LorenzSteinke/Lichtsignal_H0/README.md

# Lichtsignal_H0
Light Signal for model railway in gauge H0/00
