LorenzSteinke/Lichtsignal_H0/Rueckwand-Blende.stl

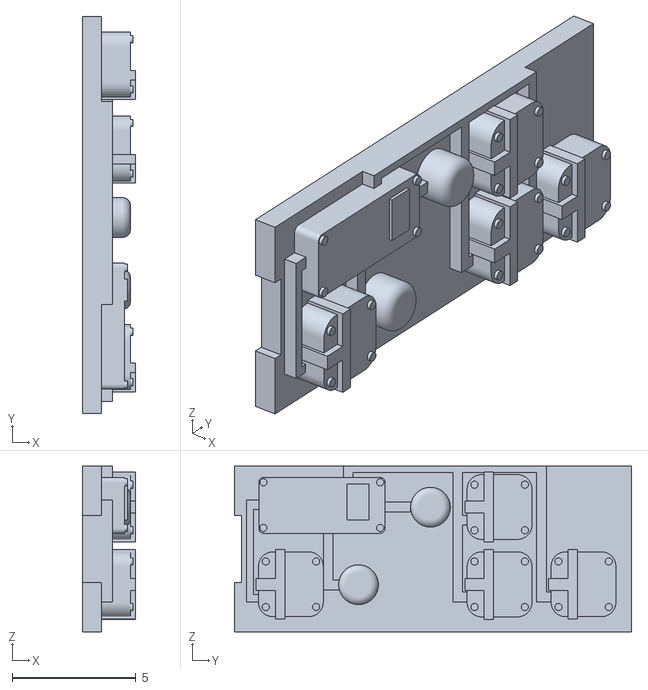
[picture p1: CAD file, 2020-01-09]
Rueckwand-Blende.stl
2.15 x 16.1 x 6.69
