LorenzSteinke/Lichtsignal_H0/Mastkorb.stl

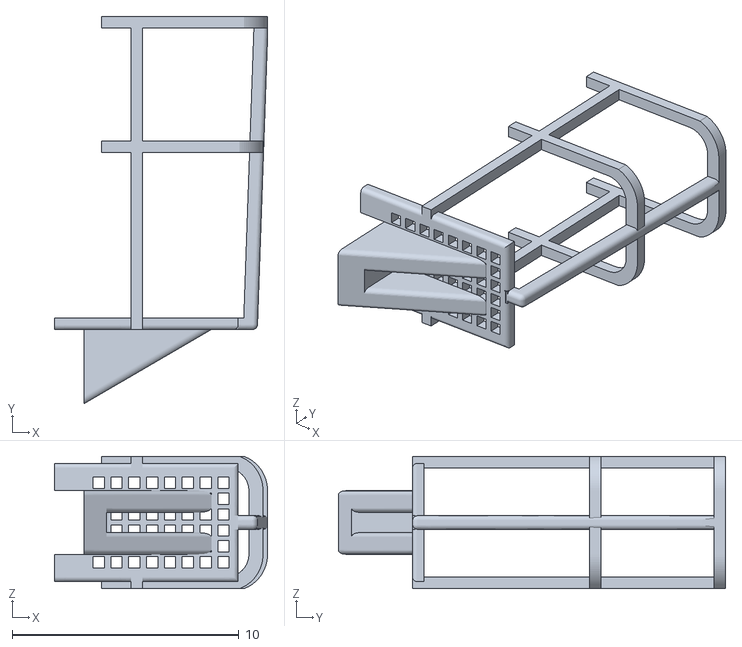
[picture p2: CAD file, 2020-01-09]
Mastkorb.stl
9.39 x 17.1 x 5.84
