LorenzSteinke/Lichtsignal_H0/Blende-Typ2.stl

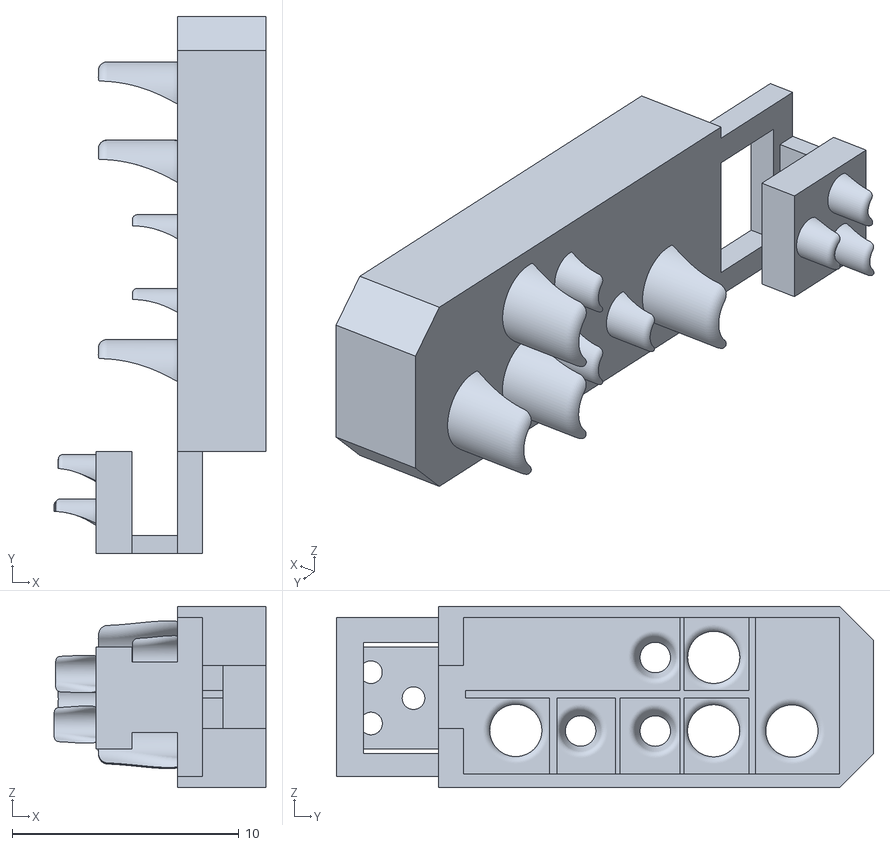
[picture p3: CAD file, 2020-01-09]
Blende-Typ2.stl
9.34 x 23.7 x 8.00
