LorenzSteinke/Lichtsignal_H0/Blende-Typ5.stl

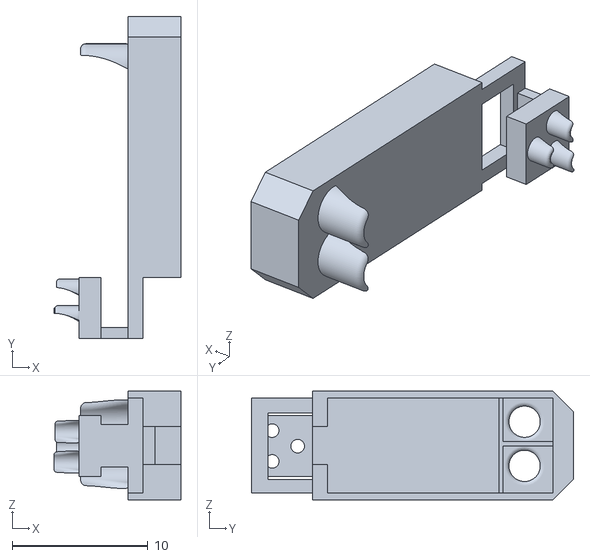
[picture p4: CAD file, 2020-01-09]
Blende-Typ5.stl
9.34 x 23.7 x 8.00
