LorenzSteinke/Lichtsignal_H0/Blende-Vorsignal.stl

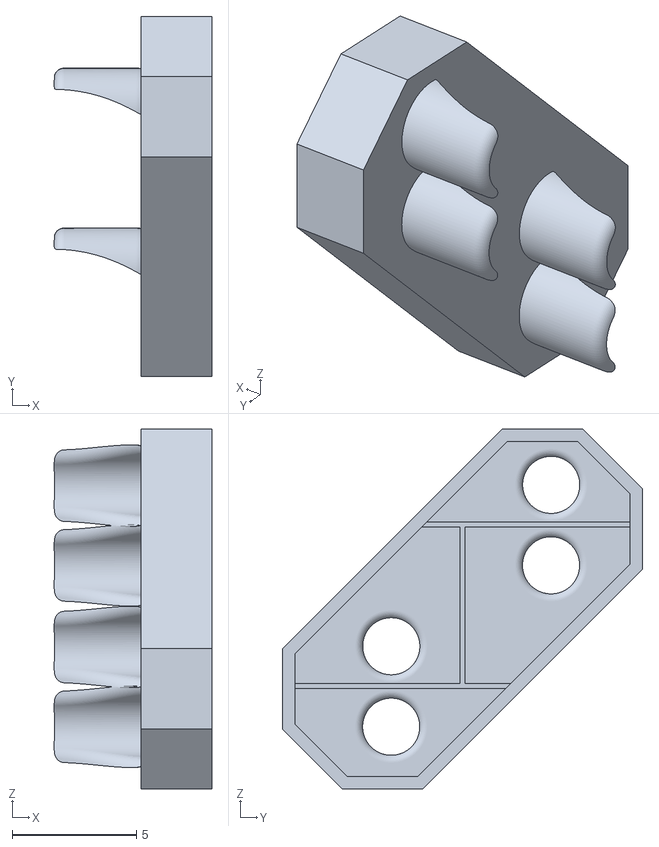
[picture p6: CAD file, 2020-01-09]
Blende-Vorsignal.stl
6.35 x 14.5 x 14.5
