LorenzSteinke/Lichtsignal_H0/Mast-mit-Vorsignal.stl

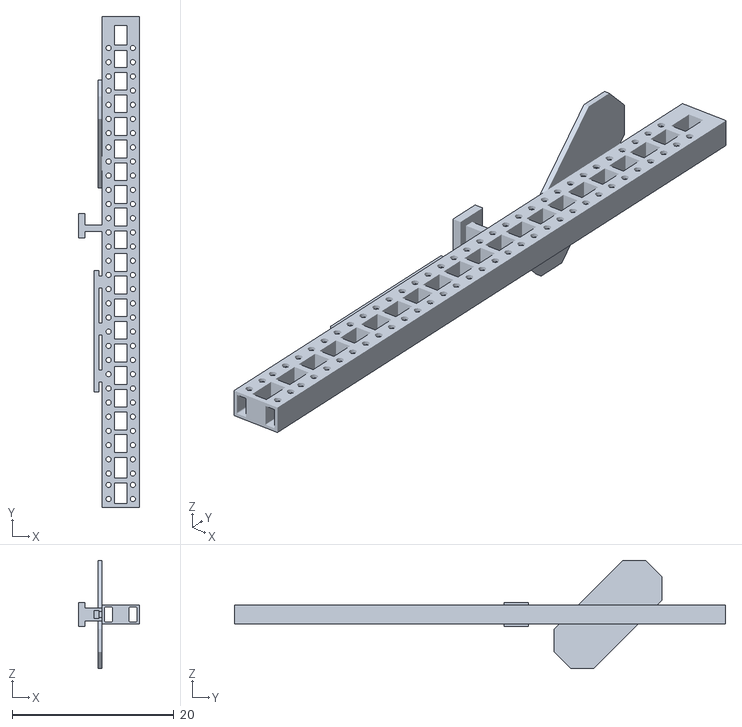
[picture p7: CAD file, 2020-01-09]
Mast-mit-Vorsignal.stl
7.50 x 60.7 x 13.4
