LorenzSteinke/Lichtsignal_H0/Blende-Vorsignal-mit-Verkuerzer.stl

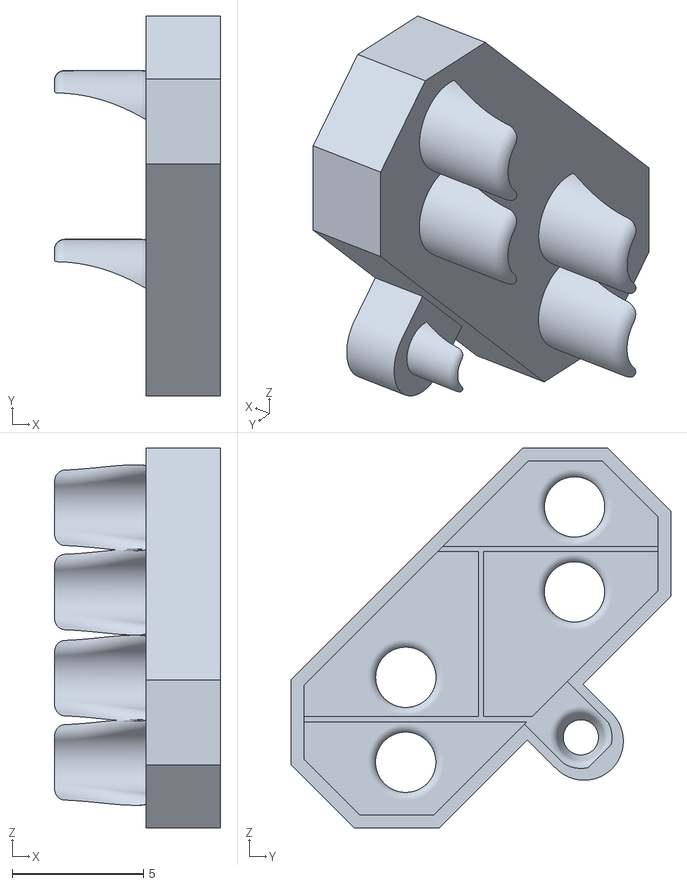
[picture p8: CAD file, 2020-01-09]
Blende-Vorsignal-mit-Verkuerzer.stl
6.35 x 14.5 x 14.5
