LorenzSteinke/Lichtsignal_H0/Verteilerkasten.stl

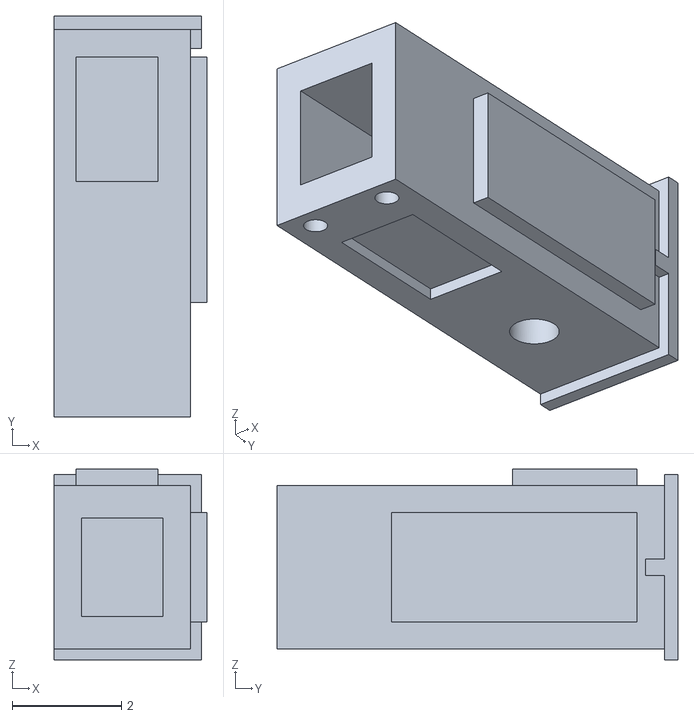
[picture p9: CAD file, 2020-01-09]
Verteilerkasten.stl
2.80 x 7.35 x 3.50
