LorenzSteinke/Lichtsignal_H0/Mastkorb-seitlich.stl

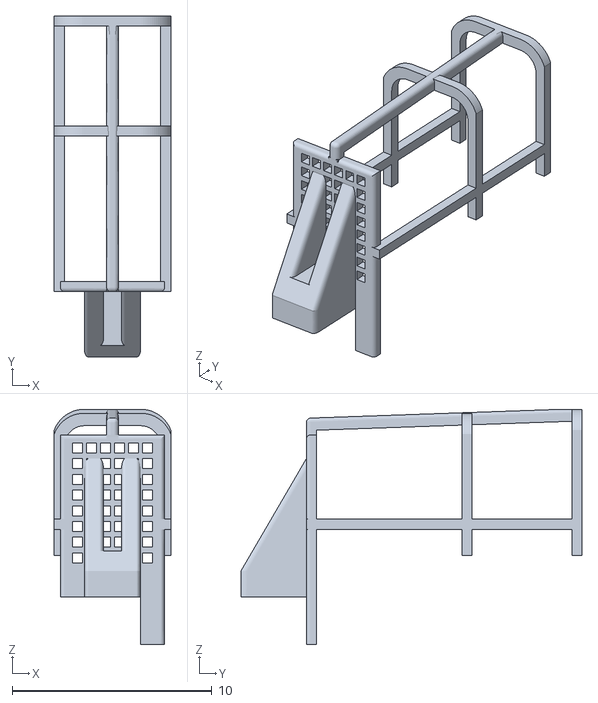
[picture p10: CAD file, 2020-01-09]
Mastkorb-seitlich.stl
5.84 x 17.1 x 11.8
