LorenzSteinke/Lichtsignal_H0/Blende-Typ1.stl

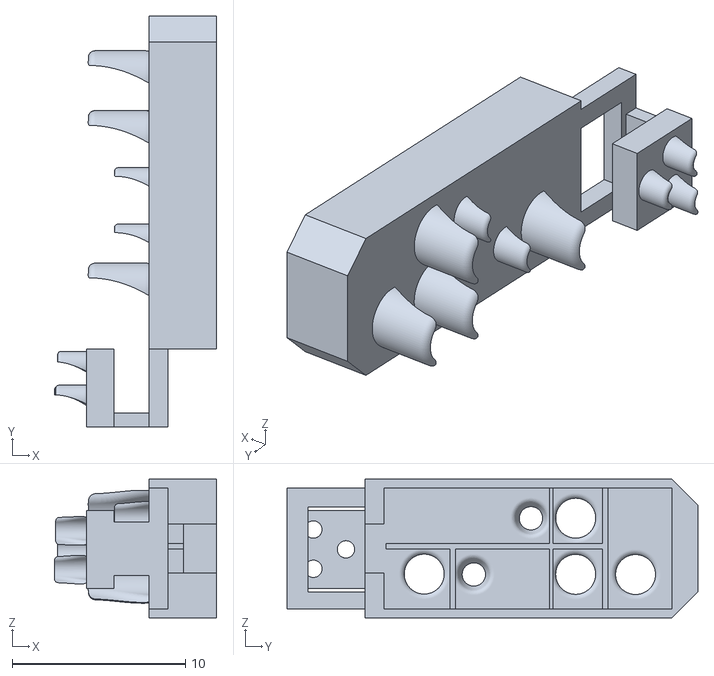
[picture p11: CAD file, 2020-01-09]
Blende-Typ1.stl
9.34 x 23.7 x 8.00
