LorenzSteinke/Lichtsignal_H0/Sockel-Platte-18mm.stl

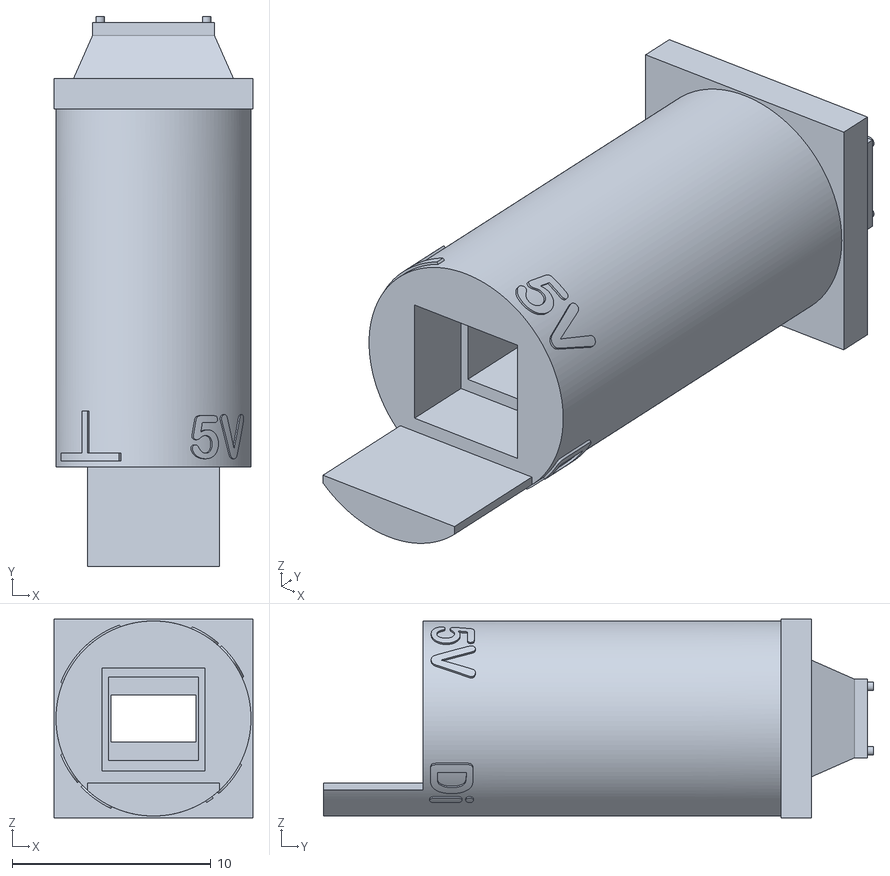
[picture p12: CAD file, 2019-12-20]
Sockel-Platte-18mm.stl
10.0 x 27.6 x 10.0
