LorenzSteinke/Lichtsignal_H0/Rueckwand.stl

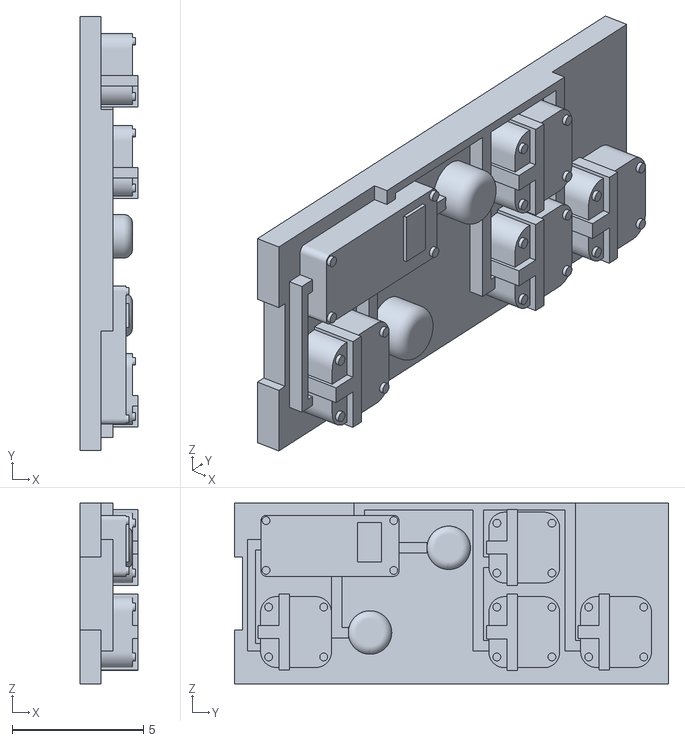
[picture p13: CAD file, 2019-12-06]
Rueckwand.stl
2.22 x 16.6 x 6.90
