LorenzSteinke/Lichtsignal_H0/Halterung-Wannenstecker-6pol.stl

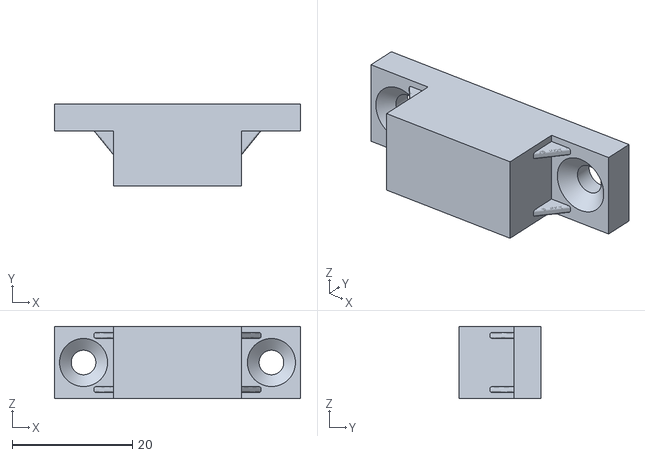
[picture p14: CAD file, 2019-11-26]
Halterung-Wannenstecker-6pol.stl
41.0 x 13.7 x 12.0
