LorenzSteinke/Lichtsignal_H0/Halterung-Wannenstecker-4pol.stl

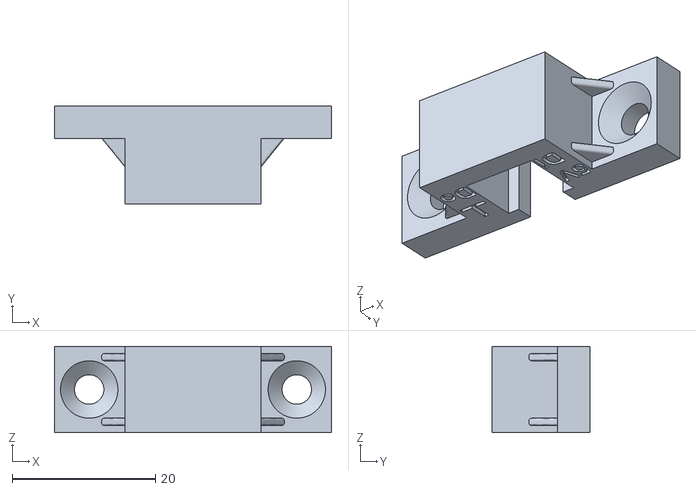
[picture p15: CAD file, 2019-11-26]
Halterung-Wannenstecker-4pol.stl
38.6 x 13.7 x 12.0
