LorenzSteinke/Lichtsignal_H0/Sockel-Platte-9mm.stl

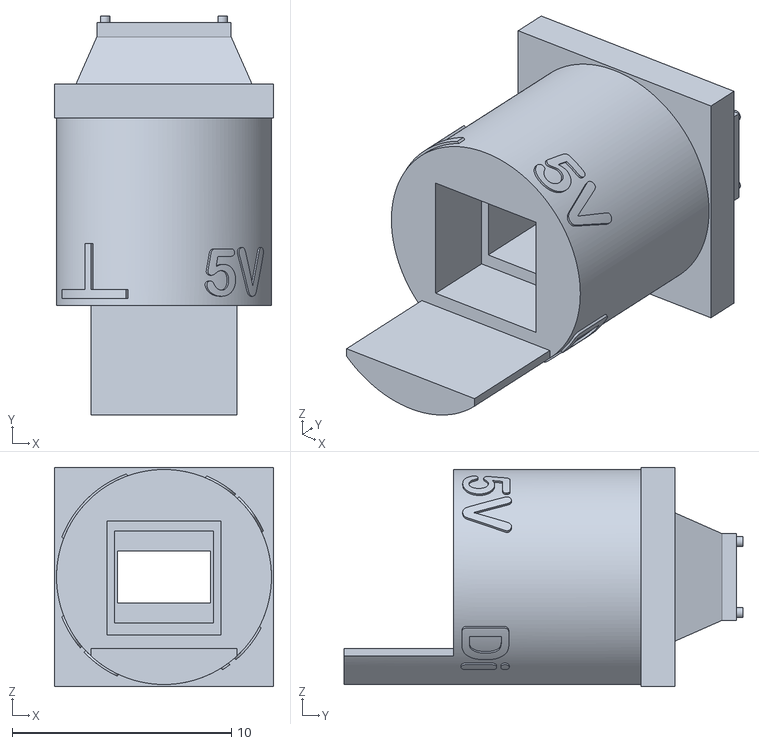
[picture p16: CAD file, 2019-11-26]
Sockel-Platte-9mm.stl
10.00 x 18.2 x 10.0
