LorenzSteinke/Lichtsignal_H0/Mast.stl

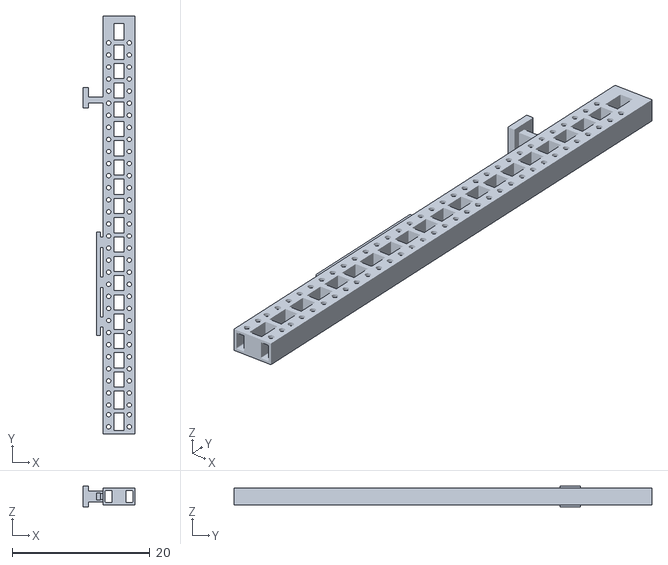
[picture p17: CAD file, 2019-11-12]
Mast.stl
7.50 x 60.7 x 3.00
