LorenzSteinke/Lichtsignal_H0/Befestigungsplatte.stl

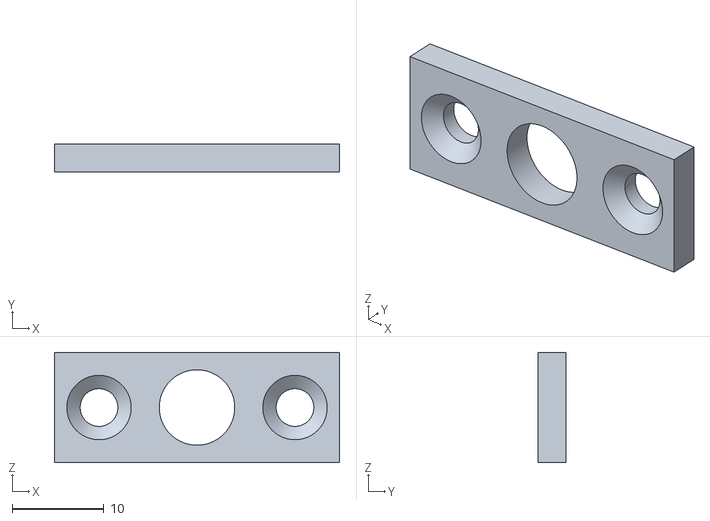
[picture p18: CAD file, 2019-11-12]
Befestigungsplatte.stl
31.0 x 3.00 x 12.0
