LorenzSteinke/Lichtsignal_H0/(list of files, cad)

Other CAD files:
Blende-Typ4.stl
