LorenzSteinke/Lichtsignal_H0/(threads)

Thread 1 (2025-04-13):

Platinen für Lichtsignale

h0schelle, 2025-04-13:
Hallo Lorenz,

kann ich von dir roplatinen(ohne Bauteile) bekommen.

Ich habe nicht die Möglichkeit selber zu ätzen.

MFG
Olaf Schellenberg

P.S

o-schelle@t-online.de

LorenzSteinke, 2025-04-13:
Hallo Olaf,

Du findest verschiedene Platinen-Typen unter https://wiki.mobaledlib.de/anleitungen/ueberblick_platinen. Platinen für den Einbau speziell in Lichtsignale sind aber aktuell noch nicht dabei. Eine sehr gute Anleitung, um das Ätzen einmal selbst auszuprobieren, falls Du das möchtest, findest Du hier: https://de.wikibooks.org/wiki/Platinen_selber_herstellen

Beste Grüße
Lorenz Steinke
